moette/amiga_bootselector/README.md

# amiga_bootselector
ATMega based Amiga Bootselector

This is an ALPHA Version. It will NOT work out of the BOX!
