moette/amiga_bootselector/doc/Programmable Amiga boot selector.docx

# Programmable Amiga boot selector

## Description

## Usage

### Initial Setup

After having installed the boot selector you will notice the two LEDs flashing three times on first power up. This indicates that the device has loaded its default settings. These are:

- Switch DF0: <> DF1:
- Toggle the boot selector on / off after RESET on the Amiga is pressed for more than 3 seconds

You can change these settings using the config-tool.

To reset the boot selector to these settings press RESET for longer than 6 seconds. If the command was recognized the LED1 will flash 5 times.

A RESET can be done by a keyboard reset (Ctrl + Left Amiga + Right Amiga) or by pressing the RESET button (if any).

### Enabling / Disabling the boot selector

You can press and hold RESET for longer than 3 seconds to enable / disable the boot selector.

If the command was recognized the LED2 will flash 3 times.

A RESET can be done by a keyboard reset (Ctrl + Left Amiga + Right Amiga) or by pressing the RESET button (if any).
