moette/amiga_bootselector/eagle/BootSel-Atmega.pdf

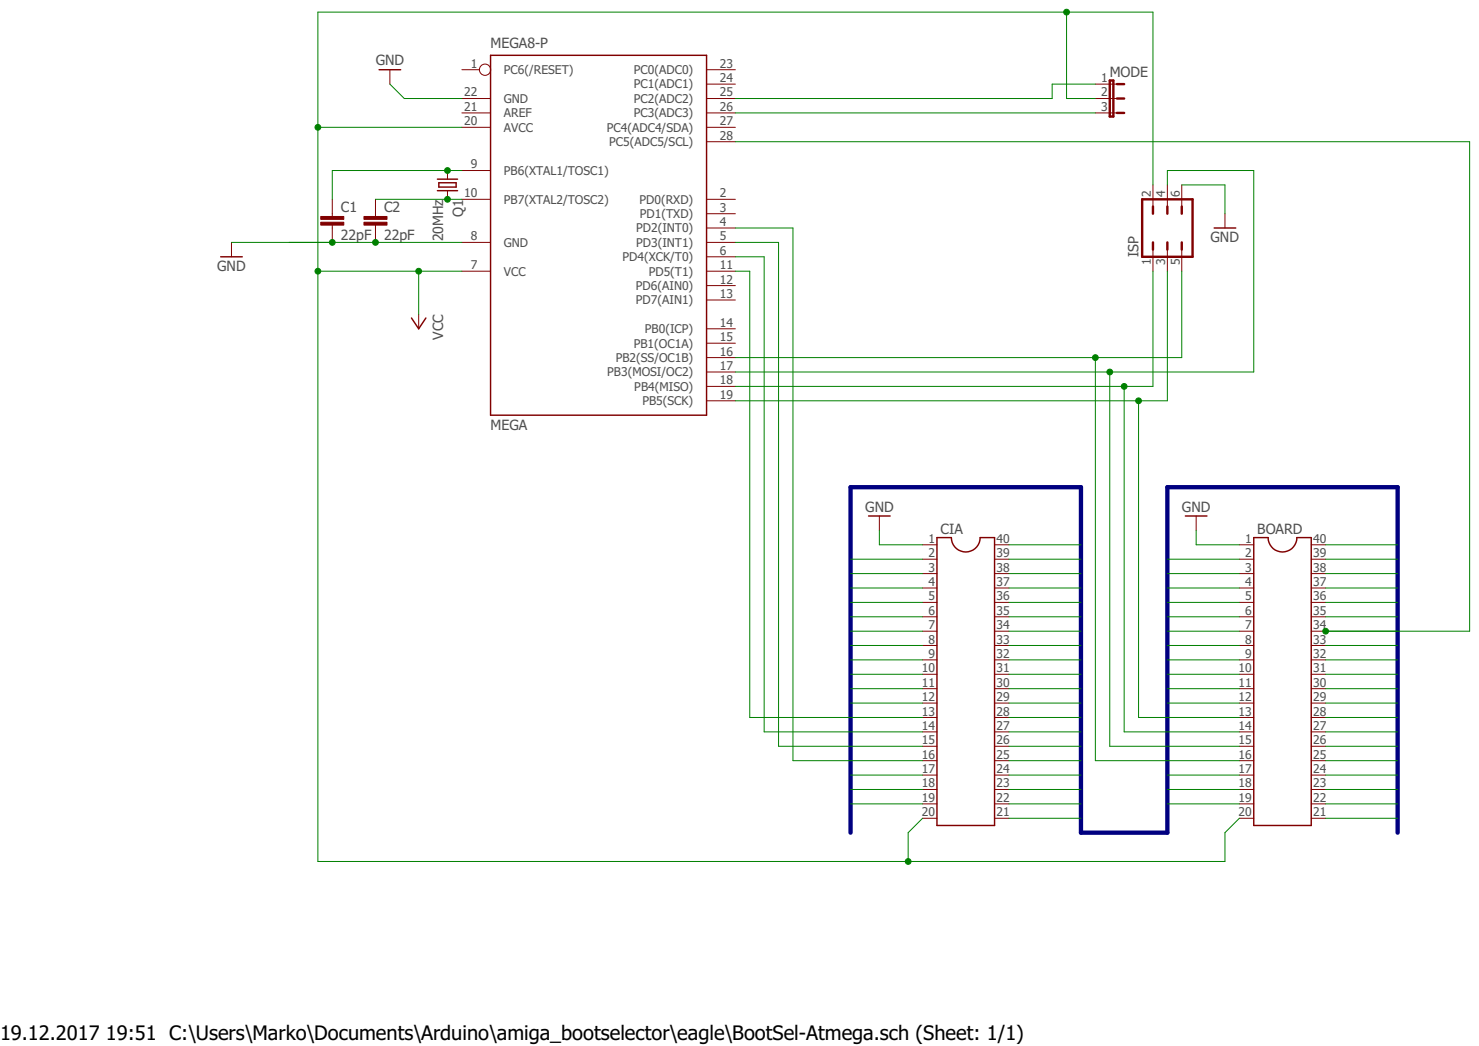
[picture p12: page 1]

19.12.2017 19:51 C:\Users\Marko\Documents\Arduino\amiga_bootselector\eagle\BootSel-Atmega.sch (Sheet: 1/1)
