moette/amiga_bootselector/eagle/BootSel-Atmega.brd

## EAGLE design eagle/BootSel-Atmega.brd (2018-02-25)

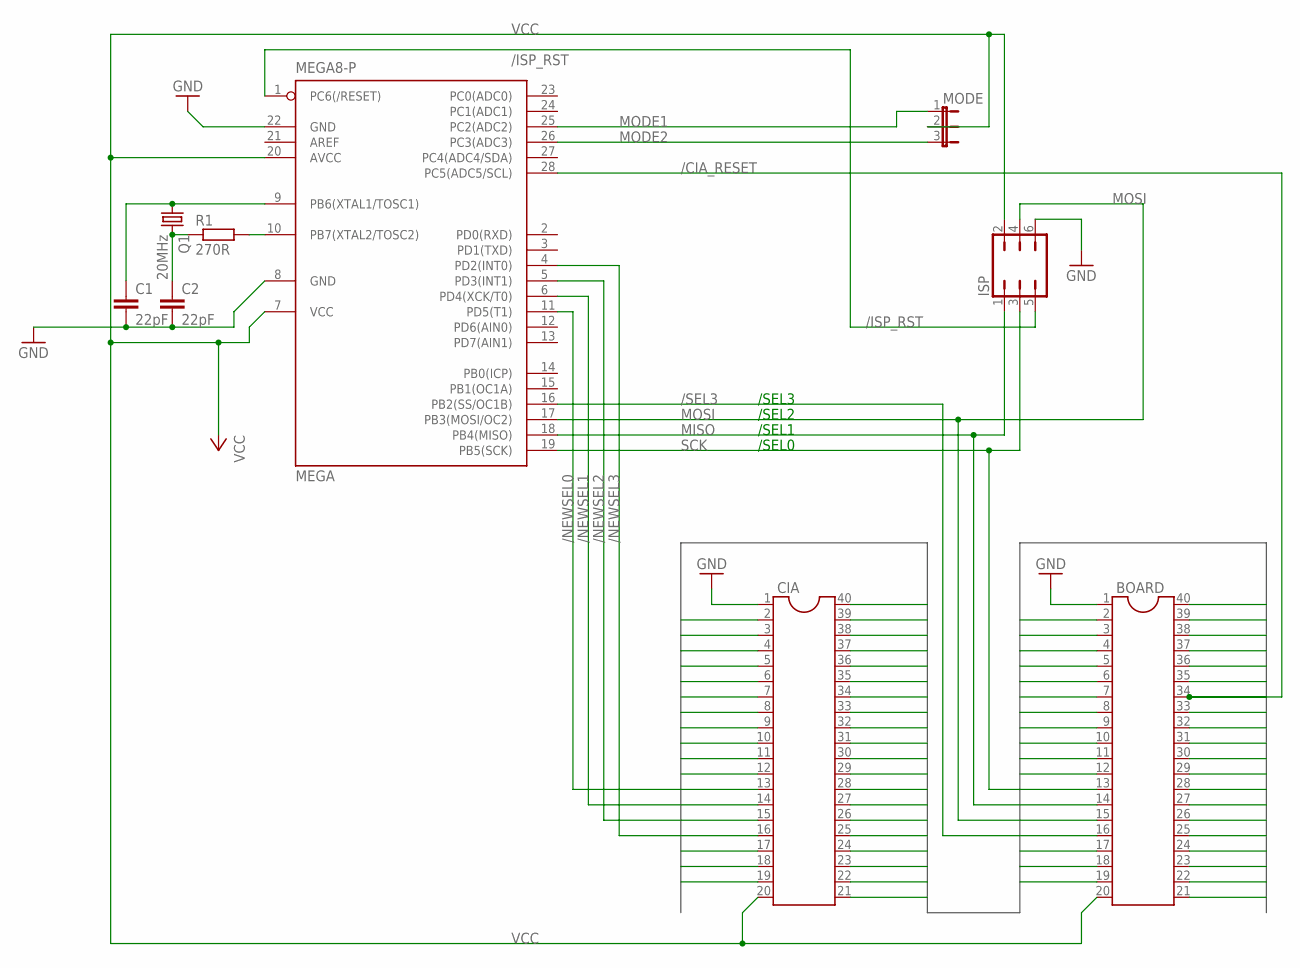
[picture p13: schematic BootSel-Atmega.sch]

Parts:
BOARD: DIL40
C1, C2: 22pF; C2.5-4
CIA: DIL40
ISP: JP3Q
MEGA: MEGA8-P; DIL28-3
MODE: JP2E; JP2
Q1: 20MHz; HC49/S
R1: 270R; 0204/5

Connections:
/CIA_RESET: BOARD.34, CIA.34, MEGA.28 (PC5(ADC5/SCL))
/ISP_RST: ISP.5, MEGA.1 (PC6(/RESET))
/NEWSEL0: CIA.13, MEGA.11 (PD5(T1))
/NEWSEL1: CIA.14, MEGA.6 (PD4(XCK/T0))
/NEWSEL2: CIA.15, MEGA.5 (PD3(INT1))
/NEWSEL3: CIA.16, MEGA.4 (PD2(INT0))
/SEL3: BOARD.16, MEGA.16 (PB2(SS/OC1B))
CIA2: BOARD.2, CIA.2
CIA3: BOARD.3, CIA.3
CIA4: BOARD.4, CIA.4
CIA5: BOARD.5, CIA.5
CIA6: BOARD.6, CIA.6
CIA7: BOARD.7, CIA.7
CIA8: BOARD.8, CIA.8
CIA9: BOARD.9, CIA.9
CIA10: BOARD.10, CIA.10
CIA11: BOARD.11, CIA.11
CIA12: BOARD.12, CIA.12
CIA17: BOARD.17, CIA.17
CIA18: BOARD.18, CIA.18
CIA19: BOARD.19, CIA.19
CIA21: BOARD.21, CIA.21
CIA22: BOARD.22, CIA.22
CIA23: BOARD.23, CIA.23
CIA24: BOARD.24, CIA.24
CIA25: BOARD.25, CIA.25
CIA26: BOARD.26, CIA.26
CIA27: BOARD.27, CIA.27
CIA28: BOARD.28, CIA.28
CIA29: BOARD.29, CIA.29
CIA30: BOARD.30, CIA.30
CIA31: BOARD.31, CIA.31
CIA32: BOARD.32, CIA.32
CIA33: BOARD.33, CIA.33
CIA35: BOARD.35, CIA.35
CIA36: BOARD.36, CIA.36
CIA37: BOARD.37, CIA.37
CIA38: BOARD.38, CIA.38
CIA39: BOARD.39, CIA.39
CIA40: BOARD.40, CIA.40
GND: BOARD.1, C1.2, C2.2, CIA.1, ISP.6, MEGA.8 (GND), MEGA.22 (GND)
MISO: BOARD.14, ISP.1, MEGA.18 (PB4(MISO))
MODE1: MEGA.25 (PC2(ADC2)), MODE.1
MODE2: MEGA.26 (PC3(ADC3)), MODE.3
MOSI: BOARD.15, ISP.4, MEGA.17 (PB3(MOSI/OC2))
unnamed: MEGA.10 (PB7(XTAL2/TOSC2)), R1.2
unnamed: C2.1, Q1.2, R1.1
unnamed: C1.1, MEGA.9 (PB6(XTAL1/TOSC1)), Q1.1
SCK: BOARD.13, ISP.3, MEGA.19 (PB5(SCK))
VCC: BOARD.20, CIA.20, ISP.2, MEGA.7 (VCC), MEGA.20 (AVCC), MODE.2

Notes on the sheet:
/SEL0
/SEL1
/SEL2
/SEL3

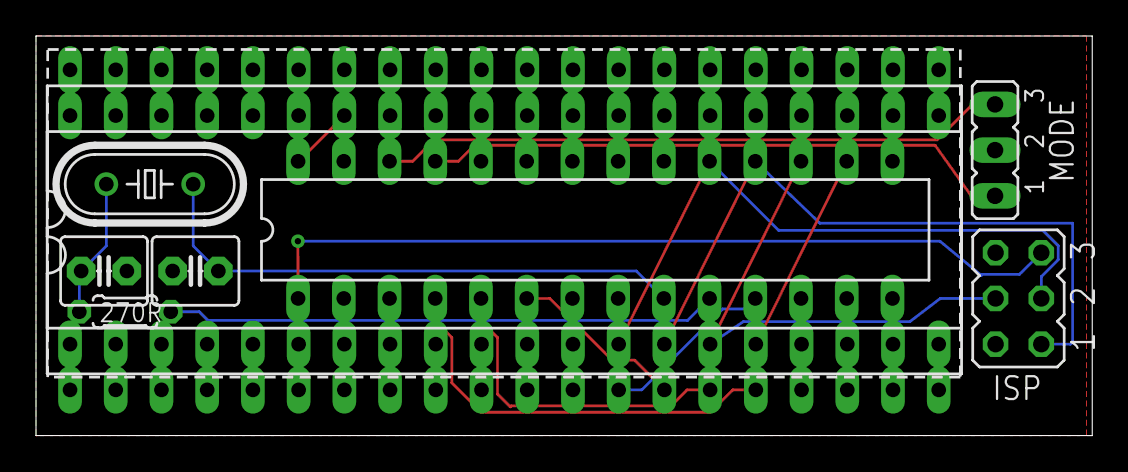
[picture p14: board BootSel-Atmega.brd from above]

Board: 2 copper layers, 58.7 x 22.2 mm, 9 parts (0 on the bottom side), 50 nets.
