moette/amiga_bootselector/JSchoenfeld-TTL-Version/eagle/Bootselector_SMD.brd

## EAGLE design JSchoenfeld-TTL-Version/eagle/Bootselector_SMD.brd (2018-02-25)

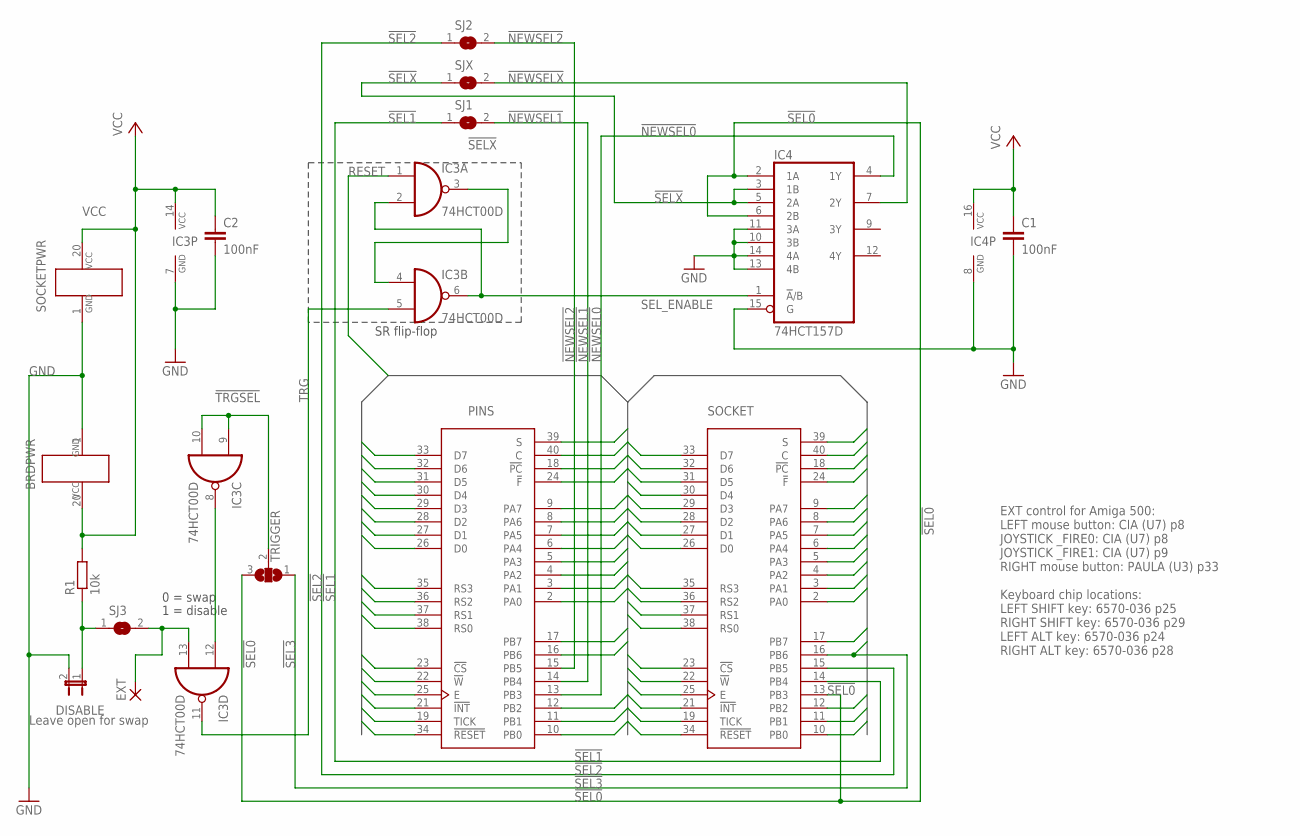
[picture p15: schematic Bootselector_SMD.sch]

Parts:
BRD: PINS; DIP40-6
C1: 100nF; C0805
C2: 100nF; C0805K
DISABLE: Leave open for swap; JP1
EXT: SMD2; SMD1,27-2,54
IC3: 74HCT00D; SO14
IC4: 74HCT157D; SO16
R1: 10k; R0805
SJ1, SJ2, SJ3: SJ
SJX: SJ
SOCKET: CIA_DIP; DIP40-6
TRIGGER: SJ2W; SJ_2

Connections:
!NEWSEL0: BRD.13 (PB3), IC4.4 (1Y)
!NEWSEL1: BRD.14 (PB4), SJ1.2
!NEWSEL2: BRD.15 (PB5), SJ2.2
!NEWSELX: IC4.7 (2Y), SJX.2
!SEL0: IC4.2 (1A), IC4.6 (2B), SOCKET.13 (PB3), TRIGGER.3
!SEL1: SJ1.1, SOCKET.14 (PB4)
!SEL2: SJ2.1, SOCKET.15 (PB5)
!SEL3: BRD.16 (PB6), SOCKET.16 (PB6), TRIGGER.1
!SELX: IC4.3 (1B), IC4.5 (2A), SJX.1
!TRGSEL: IC3.9 (I0), IC3.10 (I1), TRIGGER.2
C: BRD.40 (C), SOCKET.40 (C)
CS: BRD.23 (!CS), SOCKET.23 (!CS)
D0: BRD.26 (D0), SOCKET.26 (D0)
D1: BRD.27 (D1), SOCKET.27 (D1)
D2: BRD.28 (D2), SOCKET.28 (D2)
D3: BRD.29 (D3), SOCKET.29 (D3)
D4: BRD.30 (D4), SOCKET.30 (D4)
D5: BRD.31 (D5), SOCKET.31 (D5)
D6: BRD.32 (D6), SOCKET.32 (D6)
D7: BRD.33 (D7), SOCKET.33 (D7)
E: BRD.25 (E), SOCKET.25 (E)
F: BRD.24 (!F), SOCKET.24 (!F)
GND: BRD.1 (GND1), C1.2, C2.2, DISABLE.2, IC3.7 (GND), IC4.8 (GND), IC4.10 (3B), IC4.11 (3A), IC4.13 (4B), IC4.14 (4A), IC4.15 (G), SOCKET.1 (GND1)
INT: BRD.21 (!INT), SOCKET.21 (!INT)
unnamed: EXT.1, IC3.13 (I1), SJ3.2
unnamed: IC3.8 (O), IC3.12 (I0)
unnamed: IC3.3 (O), IC3.4 (I0)
unnamed: DISABLE.1, R1.1, SJ3.1
PA0: BRD.2 (PA0), SOCKET.2 (PA0)
PA1: BRD.3 (PA1), SOCKET.3 (PA1)
PA2: BRD.4 (PA2), SOCKET.4 (PA2)
PA3: BRD.5 (PA3), SOCKET.5 (PA3)
PA4: BRD.6 (PA4), SOCKET.6 (PA4)
PA5: BRD.7 (PA5), SOCKET.7 (PA5)
PA6: BRD.8 (PA6), SOCKET.8 (PA6)
PA7: BRD.9 (PA7), SOCKET.9 (PA7)
PB0: BRD.10 (PB0), SOCKET.10 (PB0)
PB1: BRD.11 (PB1), SOCKET.11 (PB1)
PB2: BRD.12 (PB2), SOCKET.12 (PB2)
PB7: BRD.17 (PB7), SOCKET.17 (PB7)
PC: BRD.18 (!PC), SOCKET.18 (!PC)
RESET: BRD.34 (!RESET), IC3.1 (I0), SOCKET.34 (!RESET)
RS0: BRD.38 (RS0), SOCKET.38 (RS0)
RS1: BRD.37 (RS1), SOCKET.37 (RS1)
RS2: BRD.36 (RS2), SOCKET.36 (RS2)
RS3: BRD.35 (RS3), SOCKET.35 (RS3)
S: BRD.39 (S), SOCKET.39 (S)
SEL_ENABLE: IC3.2 (I1), IC3.6 (O), IC4.1 (!A!/B)
TICK: BRD.19 (TICK), SOCKET.19 (TICK)
TRG: IC3.5 (I1), IC3.11 (O)
VCC: BRD.20 (VCC1), C1.1, C2.1, IC3.14 (VCC), IC4.16 (VCC), R1.2, SOCKET.20 (VCC1)
W: BRD.22 (!W), SOCKET.22 (!W)

Notes on the sheet:
SR flip-flop
1 = disable
0 = swap
EXT control for Amiga 500: LEFT mouse button: CIA (U7) p8 JOYSTICK _FIRE0: CIA (U7) p8 JOYSTICK _FIRE1: CIA (U7) p9 RIGHT mouse button: PAULA (U3) p33 Keyboard chip locations: LEFT SHIFT key: 6570-036 p25 RIGHT SHIFT key: 6570-036 p29 LEFT ALT key: 6570-036 p24 RIGHT ALT key: 6570-036 p28

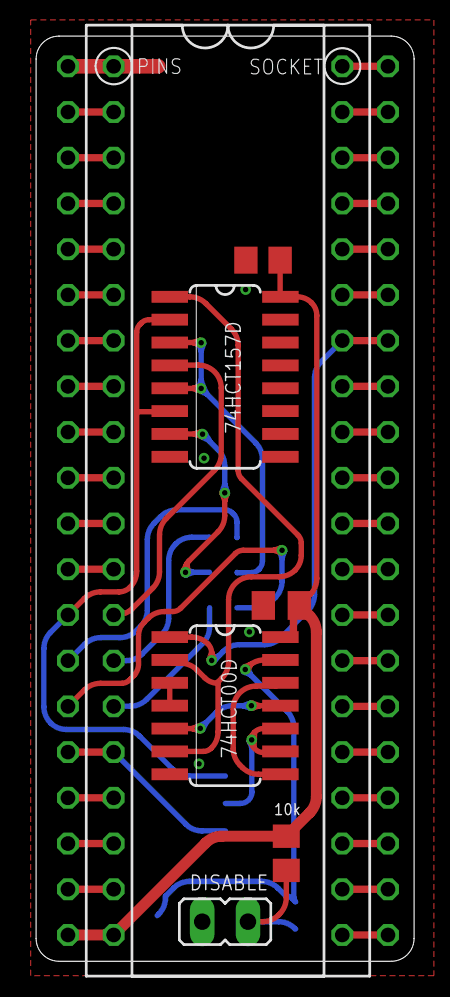
[picture p16: board Bootselector_SMD.brd from above]

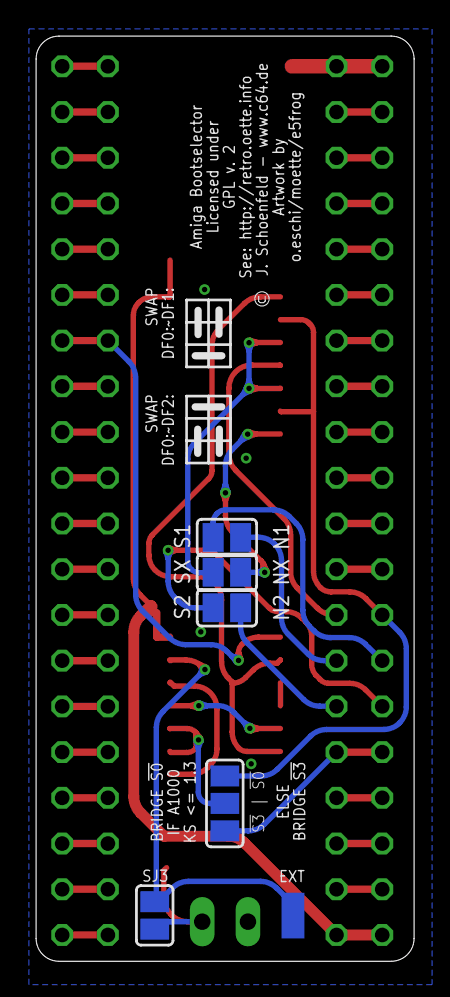
[picture p17: board Bootselector_SMD.brd from below]

Board: 2 copper layers, 21.0 x 51.4 mm, 14 parts (6 on the bottom side), 52 nets.
