moette/amiga_bootselector/JSchoenfeld-TTL-Version/eagle/Bootselector.brd

## EAGLE design JSchoenfeld-TTL-Version/eagle/Bootselector.brd (2018-02-01)

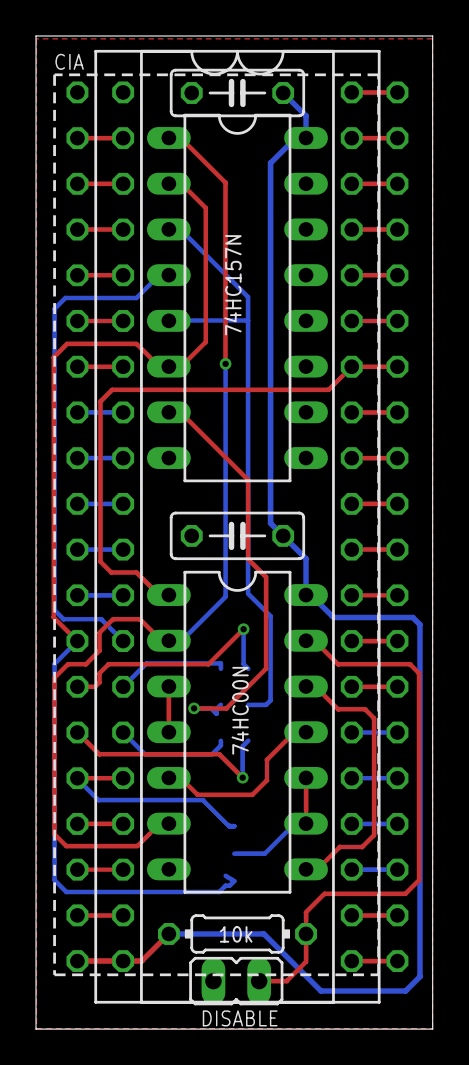
[picture p18: board Bootselector.brd from above]

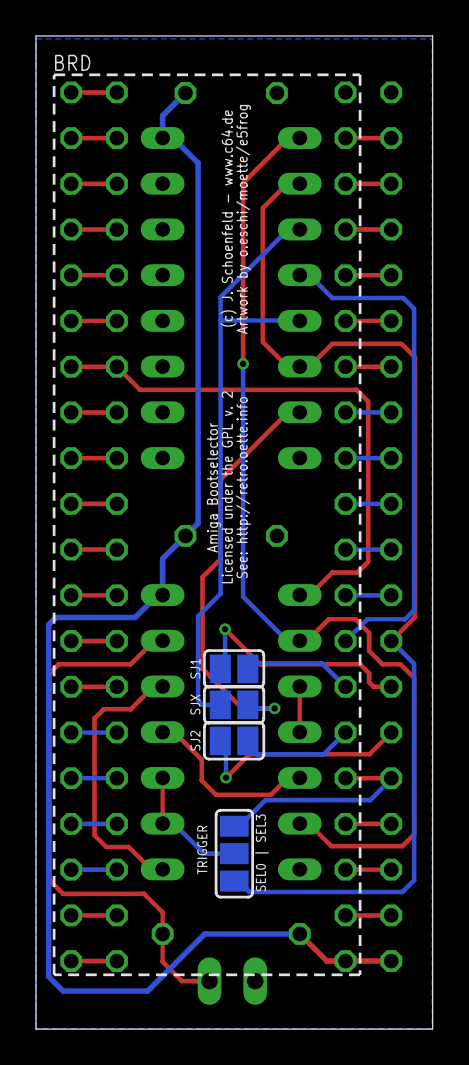
[picture p19: board Bootselector.brd from below]

Board: 2 copper layers, 22.0 x 55.2 mm, 12 parts (4 on the bottom side), 51 nets.

Parts:
BRD: DIP40-6
C1, C2: 100nF; C050-025X075
CIA: DIP40-6
DISABLE: JP1
IC3: 74HC00N; DIL14
IC4: 74HC157N; DIL16
R1: 10k; 0204/7
SJ1, SJ2: SJ
SJX: SJ
TRIGGER: SJ_2

Connections:
/NEWSEL0: BRD.13, IC4.4
/NEWSEL1: BRD.14, SJ1.2
/NEWSEL2: BRD.15, SJ2.2
/NEWSELX: IC4.7, SJX.2
/SEL0: CIA.13, IC4.2, IC4.6, TRIGGER.3
/SEL1: CIA.14, SJ1.1
/SEL2: CIA.15, SJ2.1
/SEL3: BRD.16, CIA.16, TRIGGER.1
/SELX: IC4.3, IC4.5, SJX.1
/TRGSEL: IC3.9, IC3.10, TRIGGER.2
C: BRD.40, CIA.40
CS: BRD.23, CIA.23
D0: BRD.26, CIA.26
D1: BRD.27, CIA.27
D2: BRD.28, CIA.28
D3: BRD.29, CIA.29
D4: BRD.30, CIA.30
D5: BRD.31, CIA.31
D6: BRD.32, CIA.32
D7: BRD.33, CIA.33
E: BRD.25, CIA.25
F: BRD.24, CIA.24
GND: BRD.1, C1.2, C2.2, CIA.1, DISABLE.2, IC3.7, IC4.8, IC4.10, IC4.11, IC4.13, IC4.14, IC4.15
INT: BRD.21, CIA.21
unnamed: DISABLE.1, IC3.13, R1.1
unnamed: IC3.8, IC3.12
unnamed: IC3.3, IC3.4
PA0: BRD.2, CIA.2
PA1: BRD.3, CIA.3
PA2: BRD.4, CIA.4
PA3: BRD.5, CIA.5
PA4: BRD.6, CIA.6
PA5: BRD.7, CIA.7
PA6: BRD.8, CIA.8
PA7: BRD.9, CIA.9
PB0: BRD.10, CIA.10
PB1: BRD.11, CIA.11
PB2: BRD.12, CIA.12
PB7: BRD.17, CIA.17
PC: BRD.18, CIA.18
RESET: BRD.34, CIA.34, IC3.1
RS0: BRD.38, CIA.38
RS1: BRD.37, CIA.37
RS2: BRD.36, CIA.36
RS3: BRD.35, CIA.35
S: BRD.39, CIA.39
SELENABLE: IC3.2, IC3.6, IC4.1
TICK: BRD.19, CIA.19
TRG: IC3.5, IC3.11
VCC: BRD.20, C1.1, C2.1, CIA.20, IC3.14, IC4.16, R1.2
W: BRD.22, CIA.22
