moette/amiga_bootselector/amiga_bootselector.ino

///////////////////////////////////////
// Amiga Bootselector
//
// (c) 2017 Marko Oette (http://retro.oette.info)
// 
// https://github.com/moette/amiga_bootselector
//
// Write this WITHOUT Arduino bootloader (using ISP!)
//
//  
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
/*
PORTB Wiring
      ,------->/SEL0 (out)
      | ,----->/SEL2 (out)
      | | ,--->LED1  (out)
   B00111111
       | | '-->LED2  (out)
       | '---->/SEL3 (out)
       '------>/SEL1 (out)

PORTD Wiring
      ,-------</SEL0 (in)
      | ,-----</SEL2 (in)
      | | ,---
   B00111111
       | | '--
       | '----</SEL3 (in)
       '------</SEL1 (in)

PORTC Wiring
      ,-------
      | ,-----
      | | ,---
   B00111111
       | | '--
       | '----
       '------</RESET (in, A5)
*/

#include <EEPROM.h>

#define PINMASK  B00111100
#define SEL0MASK B00100000
#define SEL0POS 5
#define SEL1MASK B00010000
#define SEL1POS 4
#define SEL2MASK B00001000
#define SEL2POS 3
#define SEL3MASK B00000100
#define SEL3POS 2

#define LED1MASK B00000010
#define LED2MASK B00000001

#define CIA_RESET_MASK B00100000       // LOW Active

#define WOMLOADDELAY 500      // Time the /SEL0 line has to be active to distinguish the A1000 WOM loader from Kickstart

#define EPROM_ADDR_SETUPFLAG  1
#define EPROM_ADDR_ACTIVEFLAG 2

bool b_enabled = true;        // true if the swapping of SEL lines is enabled
bool b_waitForReady = true;   // true when the main loop is waiting for the drives to be scanned

unsigned volatile short SRC1 = SEL0POS, DST1 = SEL1POS;

/**
 * Will flash the LED identified by 'mask'.
 * Blocks execution!!
 */
inline void flashLED(short mask, short times, int dly = 80 )
{
  while( times --> 0 )
  {
      // Blink the LEDs
      PORTB |= mask;
      delay(dly);
      PORTB &= ~mask;
      delay(dly);
  }
}

/**
 * Swaps two bits in the given byte.
 */
inline unsigned short swapBits(unsigned short n, unsigned short p1, unsigned short p2)
{
  return (((n >> p1) & 1) == ((n >> p2) & 1) ? n : ((n ^ (1 << p2)) ^ (1 << p1)));
}

/**
 * Called periodically to forward digital readings from /SEL0-3 to the output pins.
 */
unsigned volatile short org = 0;
inline void forward(bool swapped)
{
  unsigned short rd = (PINMASK & PIND);
  if( org != rd )
  {
    if( swapped )
      PORTB =(swapBits(rd, DST1, SRC1)); 
    else
      PORTB = rd;

    org = rd;
  }
}

/**
 * Waits until 
 *  - /SEL3 was triggered or 
 *  - /SEL0 was active for at least WOMLOADDELAY (ms) to detect the A1K WOM loader
 *  
 *  SEL0-3 are forwarded unchanged in this function.
 */
inline void waitForReady()
{
  // get start time
  unsigned long stime = millis();
  
  // Wait for the drives to be scanned by kickstart or for the A1k WOM loader...
  while (true)
  {
    // Pass through the org. signals
    forward(false);

    // If SEL3 goes low the last drive is scanned and we can switch
    if ( ( PIND & SEL3MASK ) != SEL3MASK )
    {
      //delay(10);
      break;
    }
    // TODO: Add Amiga 1000 WOM Loader detection code
    /* else if( ( PIND & SEL0MASK ) == SEL0MASK && (micros() - wtime) > WOMLOADDELAY)
    {
      // If SEL0 is LOW for a longer period, the A1k WOM LOADER is active
      break;
    }*/
  }
}

/**
 * Init the atmega. 
 * Set the output pins. 
 * Read the setup from the EEPROM or initialize it if necessary.
 */
void setup()
{
  // Enable outputs
  DDRB = DDRB | B00111111;
 
  // Read EPROM
  if( ( EEPROM.read(EPROM_ADDR_SETUPFLAG) == 255 ) )
  {
    // EEPROM was never written.
    flashLED((LED1MASK|LED2MASK), 3, 50);
    
    // Write defaults.
    EEPROM.write(EPROM_ADDR_ACTIVEFLAG, 1);
    b_enabled = true;

    //TODO READ+WRITE DEST-SRC1+2

    // Done. Save setup sate.
    EEPROM.write(EPROM_ADDR_SETUPFLAG, 1);
  }
  else
  {
    b_enabled = ( EEPROM.read(EPROM_ADDR_ACTIVEFLAG) == 1 );

    //TODO READ+WRITE DEST-SRC1+2
  }
  
}

/**
 * Reset Handler called by loop()
 */
void HandleReset()
{
  PORTB |= LED1MASK;
  
  unsigned long rstart = millis();
  while( ( PINC & CIA_RESET_MASK ) == 0 )
  {
  }
  unsigned long rduration = millis() - rstart;
  if( rduration > 6000 )
  {
    // RESET TO DEFAULTS!
    EEPROM.update(EPROM_ADDR_SETUPFLAG, 255 );
    flashLED(LED1MASK, 5, 40);
  }
  else if( rduration > 2500 )
  {
    // TOGGLE ON/OF
    b_enabled = (b_enabled ? false : true);
    EEPROM.update(EPROM_ADDR_ACTIVEFLAG, b_enabled ? 1 : 0);

    flashLED(LED2MASK, 3, 50);
  }

  PORTB &= ~LED1MASK;
}

/**
 * Main loop
 * - Handles RESET
 * - Handles drive initialization
 * - Handles SEL0-3 forwarding
 */
void loop()
{
  // Use a while loop to prevent funtion calls every "loop".
  while(true)
  {
    // Handle RESET
    if( ( PINC & CIA_RESET_MASK ) == 0 )
    {
      // Reset is triggered
      HandleReset();
      b_waitForReady = true;
    }
  
    // Wait for Kickstart / WOM Loader if enabled
    if( b_enabled && b_waitForReady )
    {
      waitForReady();
      b_waitForReady = false;
    }
  
    // Forward the SEL signals
    forward(b_enabled);
  }  
}
