moette/amiga_bootselector/(commit log)

2018-01-03 Adding Eagle files
    [BootSel-Atmega.brd, BootSel-Atmega.sch, Bootselector.brd, Bootselector.sch]
2018-01-07 smaller changes
    [BootSel-Atmega.brd, BootSel-Atmega.sch, Bootselector.brd, Bootselector.sch]
2018-01-27 Added documentation.pdf for TTL version. Move TTL version one directory level up so it is easier to find.
    [BootSel-Atmega.brd, Bootselector.brd, Bootselector.sch]
2018-02-01 Changes by 'e5frog' - SMT version, updated THT version.
    [Boot_selector_SMD.brd, Boot_selector_SMD.sch, Bootselector.brd]
2018-02-25 25.02.2018 - Fredric QJ Blåholtz (e5frog) + Marko Oette (marko@oette.info) v. 0.98 - Prototyping v 0.97 done, works - Updated SMD version to match THT version - Updated documentation for THT version 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
    [Bootselector_SMD.brd, Bootselector_SMD.sch]
2018-02-25 Fixed ISP connecotor.
    [BootSel-Atmega.brd, BootSel-Atmega.sch]
2018-03-15 Added Gerber file with silk screen ;)
