moette/amiga_bootselector/(notices)

Notices in the files:
amiga_bootselector.ino:
This program is free software: you can redistribute it and/or modify
it under the terms of the GNU General Public License as published by
the Free Software Foundation, either version 3 of the License, or
(at your option) any later version.
eagle/BootSel-Atmega.brd:
(c) 2018 Marko Oette
